jalexandra/yii8yw-thesis/doc/images/centralized_logical_plan.png

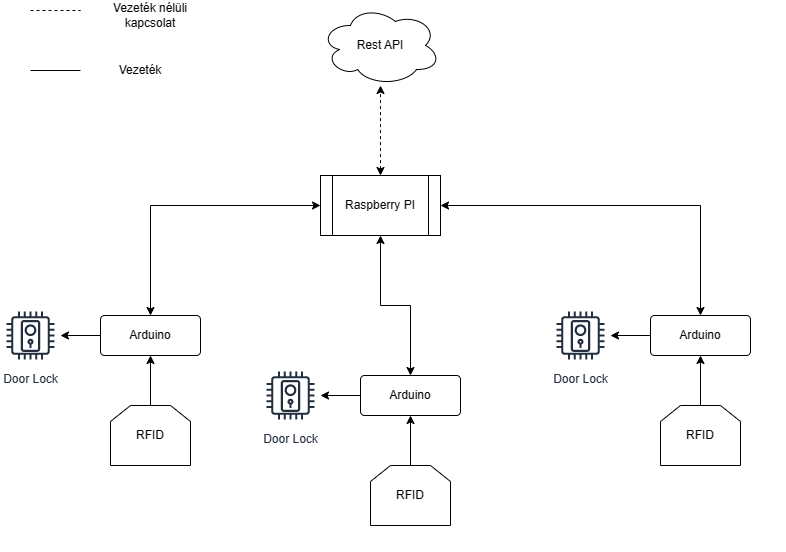
doc/images/centralized_logical_plan.png
