jalexandra/yii8yw-thesis/doc/images/distributed_logical_plan.png

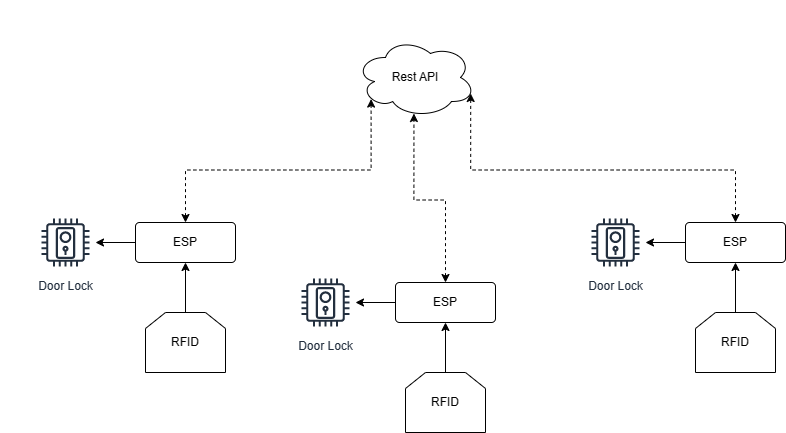
doc/images/distributed_logical_plan.png
